fawzben/drone/assembly_layout.md

### First idea

- will need to print more plates, adapted for the following layout (made like this bc don't want to stack em all up vertically, would be too tall => need to use plane space)







(1) bottom floor (2) middle floor (3) top floor 

stand offs to go throuh all 3
