fawzben/drone/CAD.md

### Frame CAD in Fusion

- Went for a 60x60 centerplate (possible to exend it to a rectangle later, no overlapping with the propellers)

- 5-inch propellers => 127 diameter



- **Bending moment strategy** : for the arms, the max. bending moment caused by the thrust (applied load) will be at the root (centerplate), while its minimum is at the motors. Thus, we can taper the arms to make them thinner at the propellers !

- **Unibody vs. Modular** : we'll go for modular aka multiple pieces (4 arms, 1 center plate) screwed together for easier repair/replacement. This will cost slightly more in 3d printing ¨

- **EDIT** : the centerplate is not ideal, we'll change it to a rectangular centerplate, to have more space for all holes + components. The battery below will rule the weight repartition by sliding along that rectangle til dead center CG



- possible change : will have 2 M3 bolts at the base of the arms, maybe they need to get further into the center plate



- **Layout principle :** 3 plates : the bottom one will hold the battery under it, and will serve to put bolts through. The middle one will have screws to secure the arms, and will have the electronic components stacked on it. The top one will secure the whole



- **with the holes for screws and bolts ** :
  


- Shortened the plates, and added strap slots. After running the simulations, this version will be printed



## New version 

- had to make slots and compartments for all components. I measured, calculated, and made this





*for the rest of the components, I can simply apply some blu-tack at the bottom*
