fawzben/drone/Dynamics.md

## Thrust force 



- **Propellers :** 2 CW ; 2 CCW to cancel out spin force (otherwise the drone would start spinning uncontrolably)

$$T_{tot}=2mg$$  

$$T_{i}=\frac12mg$$



Gemini estimation

## Roll and pitch from acceleration


- More in detail : 
https://www.youtube.com/watch?v=p7tjtLkIlFo

## Vibration dampening

Goal : find an insulating method that blocks vibration going into center plate components (especially IMU)

https://youtu.be/TMcUXRPpTJ4?si=pyg5SXwx1FnLabNb


*moon gel seems best for this. will try making some DIY*
