fawzben/drone/Tips.md

## Tips

To read the pulsations (PWM) from the controller on the arduino : 

	// 1. Read raw pulse length from receiver channel 2 (Pitch axis)
	int raw_pitch_pulse = pulseIn(PITCH_PIN, HIGH); // Output: ~1000 to 2000 microseconds
	
	// 2. Map raw microsecond pulse to a target tilt angle in degrees
	// If stick is centered (1500us), target angle = 0 degrees.
	// If stick is full forward (2000us), target angle = +20 degrees.
	float desired_pitch_angle = map(raw_pitch_pulse, 1000, 2000, -20.0, 20.0);



Once you have the desired pitched angle, the PID compares it with the IMU actual_pitch_angle to adjust the motors speeds

### Power management

11V is too much voltage for electronics. For this we use a little device (PDB (Power Distribution Board) with a built-in BEC (Battery Eliminator Circuit / Buck Converter), or an ESC board with a 5V BEC.):



### Complementary filter



**2 jobs :**

1. converts velocity and acceleration into tilt using integration

2. uses both gyroscope and acceleration to give a more precise tilt

### Motor mixing matrix 

- Matrix that tells each motor how much power (with microseconds units) to produce in order to achieve the wanted position/movement. The ESCs translates microseconds pulse signals to actual RPM.



### ESP32 signal to ESCs

[ Software Mixer ] ──(1000 to 2000 µs)──> [ ESP32 LEDC PWM Hardware ] ──(High/Low Pulses)──> [ ESC ] ──(3-Phase AC)──> [ Motor Spins at RPM ]

- We choose 4 output pins to transmit the signals for 4 motors to the ESC
