fawzben/drone/Shopping_list.md

[Material.md](https://github.com/user-attachments/files/30183668/Material.md)

| | |
| --- | --- |
| Bought (so far ≈245chf): | To buy : |
|ESP32 micrcontroller (51.8 × 29.0 × 15.0) (13g) | |
|IMU sensor (21x16) (3g) | |
|Breadboard + Jumper Wires + silicone wire checker/alarm | maybe https://www.adafruit.com/product/4502 aka new IMU bc MPU not the best
|Soldering kit + solder wire + shrinking heat sleeve| |
|propellers x6 + motors x4 + banana-to-xt6 + 4-in-1 esc + power regulator | 
|Pocket master (radio controller) + batteries + receiver ≈ 120chf
|3s (or 4s) LiPo battery (95 x 34 x 31 mm) |
| (200g) + battery charger + voltage
