fawzben/drone/DRONE_FRAME_FAWZ.3mf

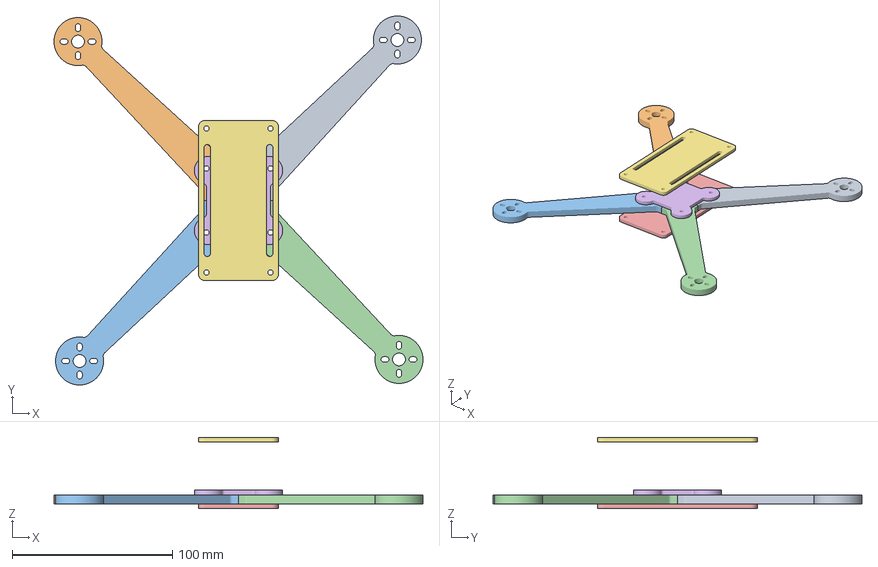
[picture p1: CAD file, 2026-09-02]
DRONE_FRAME_FAWZ.3mf
230.6 x 230.6 x 44.5 mm
arm1
arm2
arm3
arm4
bottom_plate
center_plate
top_plate
