fawzben/drone/JOURNAL.md

# ME-PROJECT-BUILDING-A-DRONE-FROM-SCRATCH
Summer holiday between 1st and 2nd year EPFL ME. I want to build a fully functional drone

## Entry 1 (19/07/26)

### Goal :
- Document about how drones work  
- Find subjects I will have to look into. 
- Detail a 1st PRD (cahier des charges)  

### Today's status :  

Loads of electronics, solid mechanics. Some programming, thermodynamics, fluid mechanics. 

**Key components :**

- IMU : ONBOARD sensor that gives real-time drone orientation (accelerometer, gyroscope,...)
- Batteries : 1 for each propeller, gives power for thrust
- ESCs : 1 for each propeller, tells the battery how much power to allow at each moment (speed change)
- microcontroller : ONBOARD (probably) arduino (raspberry has OS-related delays, not optimal for high frequency commands)
- Radio controller : transmits the user's commands to the Arduino
- Radio receiver : wired to the arduino, makes the transit between the controller and the arduino

**Real-time process :**

1. The user does a command (ex. tilt by 10 degrees)
2. The command is radio-transmitted to the arduino
3. The IMU tells the arduino about current state (ex. titled by 8 degrees)
4. The arduino calculates the difference (e.g. here 2 degrees)
5. The arduino tells the ESCs the speed change needed to fill in that gap 

This sequence happens with a frequency of $\approx200\left\lbrack Hz\right\rbrack$




### Next steps : 

[[oscarliang.com]] for detailed drone info
- look at other DIY drone configuration to get an idea of what's doable and to-do
- get insight on electronic components, how to use them

## Entry 2 (20/08/26)

**What I did :**

- Learned how controller transmits to arduino

- Learned how arduino corrects errror using IMU and PID algorithm (detailed in [Tips])

- Started a "shopping list". To be completed later

- Start buying material (long shipping, and will let me start experiment coding). Bought electronics and soldering stuff

**Next steps :**

- Keep buying material (long shipping, and will let me start experiment coding)

- Set up coding environment

- Starting CADing drone frame, and do physics in parallel (e.g. total weight, to pick the right propellers)

- Do more of the physics (particularly dynamics, structure and material resistance)

## Entry 3 (22/08/26)

**What I did :**

- Decided to do CAD on Fusion (no need for Catia for a not-so-big construction)

- Started building the frame



## Entry 4 (25/08/26)

**What I did :**

- More CAD done, first workable/printable version ready

- Ordered the propellers and motors, only battery stuff & controller left to buy



**Next steps :**

- Maybe print the 1st version

- Look at open source code for inspo to configure the microcontroller

- (Order the other stuff)

## Entry 5 (5/08/26)

** What I did during 10 days** : 

- Ordered and received most of the material



- Edited the CAD and ran simulations

- 3D-Printed this workable frame



 - Started programming and wiring microcontroller and IMU



## Entry 6 (11/08/26)

**What I did :**

- Coded for live IMU data report. It works well, giving me 1g of acceleration and 0±1 deg/s of rotation at rest state. It also detects change in acceleration and rotational speed (cf. *IMU_data.ino*)



- We can also have it plotted, graph 1 (rot. speed) after random rotation from rest, and graph 2 (accel.) is after dropping the IMU

<p align="center">


</p>

**Next steps:**

- [x] Sensor Offset Calibration: Write a setup function that averages ~500 IMU readings while flat on your desk to calculate zero-drift offsets, then subtracts them from live readings

- [x] Attitude Filtering (Angle Calculation): Implement a Complementary Filter or Madgwick Algorithm to fuse raw accelerometer (g) and gyroscope (deg/s) data into clean Roll and Pitch angles in degrees



- [x] Non-Blocking Timing Loop: Convert your main code to run at a strict 250 Hz frequency (4000 μs period) using micros() instead of delay()

- [x] PID Controller Framework: Structure the basic Proportional-Integral-Derivative equations for Roll, Pitch, and Yaw to prepare for motor control output

- [ ] ESC Signal Generator: Set up 4 ESP32 PWM channels (or DShot protocols) on GPIO pins to verify motor throttle control signals on the Serial Plotter

- [ ] Buy radio controller + receiver + battery stuff

## Entry 7 (16/08/26)

**What I did :**

- I did the calibration. It allows for less noise and slightly better offset (*Graph 1 (left) = no calibration --- Graph 2 (right) = calibrated*)

<p align="center">
  
 

</p>

- Did the complementary filter. With mechanics (see dynamics.md) we can use gyro and accel values to compute accurate pitch and roll (not yaw tho). Code is Pitch_roll_values.ino

- It also uses micros() instead of delay() to keep the drone from freezing meanwhile



- We see a clear discrepency (in smoothness) between values from accelerometer only and from accel+gyro.

## Entry 8 (20/08/26)

**To-do** : 

- [x] PID loop : no need for actual controller data, I can manually input desired commands and check on serial plotter

- [x] Motor matrix mixer : how each motor will act to correct the PID error

- [ ] ESP32 output on ESC : exactly how signal translates to motor speed

- [ ] Buy and plug in radio receiver

## Entry 9 (30/08/26)

*Note : Pitch and roll must be capped at < |90deg| (or even ±45deg possibly) through radio sticks. Above the ±90 mark, Euler Angles and atan methods are no longer applicable (pitch and roll get mixed up,...)*

**What I did** : 

- PID loop : integrated it to the Pitch-roll complementary filter. Few edits and adjustements made (used directly gyro angular speed for derivative term, slight tuning by orders of magnitude to get reasonable correction). File is PID_IMU_combination_v3




**Healthy correction response, good frequency, not much noise. Tuning will be done once drone fully built. D_term and I_term will be more noticeable in real conditions, with wind and actual stick commands

## Entry 10 (31/08/26)

**What I did :**

Motor matrix mixer : I added the matrix to my program, and the pitch/roll/yawRate corrections now translates into motor pulse signal. 





*above each motor pulse signals for a simple roll, pitch and yaw. For yaw, it corrects the rate, so the angular speed but not the orientation (what we want) *

**ESP32 ouput on ESC**

*will use the ESP32 servo library, lightweight and simple function writeMicroseconds(pin, val)*

Pins layout (kinda arbitrary, just avoid strapping and input-only pins):

1. M1 (Rear-Right): GPIO 13
2. M2 (Front-Right): GPIO 14
3. M3 (Rear-Left): GPIO 27
4. M4 (Front-Left): GPIO 26

Arming and safety :

- must first send a 2-3sec 1000us signal to inform the ESC that the drone is at rest

- must tell the max and min signal for all motors (1000us-2000us)

*added the output pins and set up PWM channels for each motor, that I combined with PID and motor mixing. Now, the ESC receives the right pulse signals, and translates it to RPM using internal programs*

## Entry 11 (23/09/26)

**What I did**

- connected the radio receiver (bound to the controller) to the esp32. program ... now gives real time commands (20 or 50Hz) to the esp32


*setup for testing (soldering later)*

**Problems encountered** 

- 1st CRSF library (CRSFForArduino) used was not transmitting receiver data correctly. Used (AlfredoCRSF) instead, and it works perfectly, using standard functions (begin, update, getChannel)

**To-do**

- Integrate the code into PID/motormixing program (main) , replacing "target" with those values for Pitch, Roll and Yaw

## Entry 12 (11/10/26)

**What I did** : 

- soldered battery xt6 cable to ESC (was a real pain bc of cable thickness)





Got the RX code into main program, works well, gives me real time motor pulsation based both on current state AND radio commands

**To-do next** : 

- [ ] bit more soldering : rx receiver to ESP32, ESC to ESP32
- [x] Drawing and planning exact assembly with components, wires,...
- [x] OPTIONAL : CAD receptacle for components if no assembly solution

- [x] Ensure pulsation transmission to ESC and ESC converting to RPM for motors
       - [ ] needs testing after soldering

## Entry 13 (11/10/26)

**What I did** : 

- CADed a 2nd version ready-to-print model (see CAD section)

**What to do** : 

- CAD : take into account printer's parameters to do press fit on components OR zip-ties + blue tack does the trick

## Entry 14 (3/11/12)

- Printed that 2nd version & soldered a bit to ESP32



### To-do next

**Printed frame problems**

1. ESP32 case too small, change chanfrein's R / remove the screwholes on the components

2. see if zip-tie goes through

**Soldering**

1. desolder stuff to fit in frame and resolder
2. solder 1 motor to ESP32
3. cut pins on ESP32
4. unsolder and remove pins on IMU (will try and solder through the holes to keep the IMU flat)
