fawzben/drone/ESP32_ESC_output/ESP32_ESC_output.ino

#include <Wire.h>
#include <Arduino.h>
#include <ESP32Servo.h>

const uint8_t MPU_ADDR = 0x68;
const int LED_PIN = 2;

// ==========================================
// 1. MOTOR PIN CONFIGURATION & INSTANCES
// ==========================================
const int PIN_M1 = 13; // Rear-Right (CCW)
const int PIN_M2 = 14; // Front-Right (CW)
const int PIN_M3 = 27; // Rear-Left (CW)
const int PIN_M4 = 26; // Front-Left (CCW)

Servo motor1; // initiates a PWM setup for each motor
Servo motor2;
Servo motor3;
Servo motor4;

// ==========================================
// 2. PID DATA STRUCTURE & FUNCTIONS
// ==========================================
struct PIDController {
  float Kp;
  float Ki;
  float Kd;
  float maxIntegral;
  float maxOutput;
  float integral;
};

// Global PID instances
PIDController pidRoll  = {1.3f, 0.04f, 0.03f, 100.0f, 400.0f};
PIDController pidPitch = {1.3f, 0.04f, 0.03f, 100.0f, 400.0f};
PIDController pidYaw   = {2.5f, 0.02f, 0.00f,  50.0f, 400.0f};

float computePID(PIDController &pid, float target, float measured, float gyroRate, float dt) {
  float error = target - measured;
  float pTerm = pid.Kp * error;

  pid.integral += error * dt;
  pid.integral = constrain(pid.integral, -pid.maxIntegral, pid.maxIntegral);
  float iTerm = pid.Ki * pid.integral;

  float dTerm = -pid.Kd * gyroRate;

  float output = pTerm + iTerm + dTerm;
  return constrain(output, -pid.maxOutput, pid.maxOutput);
}

// ==========================================
// 3. SENSOR READING & CALIBRATION
// ==========================================
float gyroOffsetX = 0.0, gyroOffsetY = 0.0, gyroOffsetZ = 0.0;
float accOffsetX = 0.0, accOffsetY = 0.0, accOffsetZ = 0.0;

float roll = 0.0;
float pitch = 0.0;

void readRawMPU(int16_t &ax, int16_t &ay, int16_t &az, int16_t &gx, int16_t &gy, int16_t &gz) {
  Wire.beginTransmission(MPU_ADDR);
  Wire.write(0x3B);
  Wire.endTransmission(false);
  Wire.requestFrom((uint8_t)MPU_ADDR, (uint8_t)14, (uint8_t)true);

  uint8_t axH = Wire.read(); uint8_t axL = Wire.read();
  uint8_t ayH = Wire.read(); uint8_t ayL = Wire.read();
  uint8_t azH = Wire.read(); uint8_t azL = Wire.read();
  Wire.read(); Wire.read();
  uint8_t gxH = Wire.read(); uint8_t gxL = Wire.read();
  uint8_t gyH = Wire.read(); uint8_t gyL = Wire.read();
  uint8_t gzH = Wire.read(); uint8_t gzL = Wire.read();

  ax = (int16_t)(axH << 8 | axL);
  ay = (int16_t)(ayH << 8 | ayL);
  az = (int16_t)(azH << 8 | azL);
  gx = (int16_t)(gxH << 8 | gxL);
  gy = (int16_t)(gyH << 8 | gyL);
  gz = (int16_t)(gzH << 8 | gzL);
}

void calibrateSensors(int samples = 500) {
  pinMode(LED_PIN, OUTPUT);
  digitalWrite(LED_PIN, HIGH);
  delay(1500);

  float sumGx = 0, sumGy = 0, sumGz = 0;
  float sumAx = 0, sumAy = 0, sumAz = 0;

  for (int i = 0; i < samples; i++) {
    int16_t rawAx, rawAy, rawAz, rawGx, rawGy, rawGz;
    readRawMPU(rawAx, rawAy, rawAz, rawGx, rawGy, rawGz);

    sumAx += (rawAx / 4096.0);
    sumAy += (rawAy / 4096.0);
    sumAz += (rawAz / 4096.0);

    sumGx += (rawGx / 16.4);
    sumGy += (rawGy / 16.4);
    sumGz += (rawGz / 16.4);

    delay(2);
  }

  accOffsetX = sumAx / samples;
  accOffsetY = sumAy / samples;
  accOffsetZ = (sumAz / samples) - 1.0;

  gyroOffsetX = sumGx / samples;
  gyroOffsetY = sumGy / samples;
  gyroOffsetZ = sumGz / samples;

  digitalWrite(LED_PIN, LOW);
}

// Timing variables
unsigned long previousMicros = 0;
const unsigned long LOOP_TIME_US = 4000; // 250Hz loop rate
float dt = 0.004;

void setup() {
  Serial.begin(115200);

  Wire.begin(21, 22);
  Wire.setClock(400000);
  delay(100);

  // Initialize MPU-6050
  Wire.beginTransmission(MPU_ADDR);
  Wire.write(0x6B);
  Wire.write(0x00);
  Wire.endTransmission(true);

  // DLPF 42Hz
  Wire.beginTransmission(MPU_ADDR);
  Wire.write(0x1A);
  Wire.write(0x03);
  Wire.endTransmission(true);

  // Gyro +/-2000 deg/s, Acc +/-8g
  Wire.beginTransmission(MPU_ADDR);
  Wire.write(0x1B);
  Wire.write(0x18);
  Wire.endTransmission(true);

  Wire.beginTransmission(MPU_ADDR);
  Wire.write(0x1C);
  Wire.write(0x10);
  Wire.endTransmission(true);

  calibrateSensors(500);

  // Initialize orientation
  int16_t rawAx, rawAy, rawAz, rawGx, rawGy, rawGz;
  readRawMPU(rawAx, rawAy, rawAz, rawGx, rawGy, rawGz);
  float initAccX = (rawAx / 4096.0) - accOffsetX;
  float initAccY = (rawAy / 4096.0) - accOffsetY;
  float initAccZ = (rawAz / 4096.0) - accOffsetZ;

  roll = atan2(initAccY, initAccZ) * (180.0 / PI);
  pitch = atan2(-initAccX, sqrt(initAccY * initAccY + initAccZ * initAccZ)) * (180.0 / PI);

  // ==========================================
  // ATTACH MOTORS & RUN ARMING SEQUENCE
  // ==========================================
  // Standard servo/ESC bounds: 1000us to 2000us at 50Hz (just for desk testing, can go to 250Hz for flight mode)
  motor1.setPeriodHertz(50);
  motor2.setPeriodHertz(50);
  motor3.setPeriodHertz(50);
  motor4.setPeriodHertz(50);

  motor1.attach(PIN_M1, 1000, 2000); // assigns pin and sets bounds for each channel
  motor2.attach(PIN_M2, 1000, 2000);
  motor3.attach(PIN_M3, 1000, 2000);
  motor4.attach(PIN_M4, 1000, 2000);

  // Send 1000us (zero throttle) for 2 seconds to arm ESCs (security)
  motor1.writeMicroseconds(1000);
  motor2.writeMicroseconds(1000);
  motor3.writeMicroseconds(1000);
  motor4.writeMicroseconds(1000);
  delay(2000);

  previousMicros = micros();
}

void loop() {
  unsigned long currentMicros = micros();

  if (currentMicros - previousMicros >= LOOP_TIME_US) {
    dt = (currentMicros - previousMicros) / 1000000.0;
    previousMicros = currentMicros;

    int16_t rawAx, rawAy, rawAz, rawGx, rawGy, rawGz;
    readRawMPU(rawAx, rawAy, rawAz, rawGx, rawGy, rawGz);

    // 1. Calibrated sensor values
    float accX = (rawAx / 4096.0) - accOffsetX;
    float accY = (rawAy / 4096.0) - accOffsetY;
    float accZ = (rawAz / 4096.0) - accOffsetZ;

    float gyroX = (rawGx / 16.4) - gyroOffsetX;
    float gyroY = (rawGy / 16.4) - gyroOffsetY;
    float gyroZ = (rawGz / 16.4) - gyroOffsetZ;

    // 2. Complementary Filter
    float accRoll  = atan2(accY, accZ) * (180.0 / PI);
    float accPitch = atan2(-accX, sqrt(accY * accY + accZ * accZ)) * (180.0 / PI);

    roll  = 0.98 * (roll  + gyroX * dt) + 0.02 * accRoll;
    pitch = 0.98 * (pitch + gyroY * dt) + 0.02 * accPitch;

    // 3. Setpoints
    float targetRollAngle  = 0.0f;
    float targetPitchAngle = 0.0f;
    float targetYawRate    = 0.0f;

    // 4. Compute PID Corrections
    float rollCorrection  = computePID(pidRoll,  targetRollAngle,  roll,  gyroX, dt);
    float pitchCorrection = computePID(pidPitch, targetPitchAngle, pitch, gyroY, dt);
    float yawCorrection   = computePID(pidYaw,   targetYawRate,    gyroZ, 0.0f,  dt);

    // 5. Motor Mixer
    // Keep at 1000 (stopped) on desk for safety, or 1150-1300 for live bench testing
    float baseThrottle = 1000.0f;

    int m1 = (int)constrain(baseThrottle - rollCorrection + pitchCorrection - yawCorrection, 1000.0f, 2000.0f); // gives pulse signal
    int m2 = (int)constrain(baseThrottle - rollCorrection - pitchCorrection + yawCorrection, 1000.0f, 2000.0f);
    int m3 = (int)constrain(baseThrottle + rollCorrection + pitchCorrection + yawCorrection, 1000.0f, 2000.0f);
    int m4 = (int)constrain(baseThrottle + rollCorrection - pitchCorrection - yawCorrection, 1000.0f, 2000.0f);

    // 6. Write Physical PWM Output to Motors
    motor1.writeMicroseconds(m1);
    motor2.writeMicroseconds(m2);
    motor3.writeMicroseconds(m3);
    motor4.writeMicroseconds(m4);
  }
}
