fawzben/drone/(commit log)

2026-08-11 Add entry for live IMU data report
    Documented the implementation of a live IMU data report, including performance metrics and a screenshot.
2026-08-11 Document next steps for project development
    Added next steps for sensor calibration, attitude filtering, timing loop, PID controller, and hardware purchases.
2026-08-16 Add complementary filter section to Tips.md
    Added a section on complementary filters, detailing their function and usage.
2026-08-17 Update Dynamics.md with new sections and images
    Added new sections for thrust force and roll/pitch from acceleration.
2026-08-31 Update JOURNAL.md with ESP32 and ESC details
    Documented ESP32 output configuration for ESC and motor pin layout, including arming and safety procedures.
2026-08-31 Revise motor pin layout and safety instructions
    Updated motor pin layout and added details on arming and safety procedures.
2026-10-11 Document soldering and RX code integration in JOURNAL.md
    Added entry 12 detailing soldering work and updates to the RX code integration.
2026-10-16 Add images to assembly_layout.md
    Added two images to the assembly layout documentation.
2026-10-16 Introduce new layout idea for assembly
    Added a new layout idea with images and descriptions.
2026-10-16 Enhance assembly layout with more images and notes
    Added additional images and layout details for assembly.
2026-11-03 Rename All right, let's talk about hardware management.... - All right, let's talk about hardware management.....pdf to ESP32 PORTS
2026-11-03 Document updates in JOURNAL.md for entry 14
    Added entry 14 with updates on the printed version and soldering tasks.
